tforgeworks/Perry-s-repo/wheel-cap/wheel_cap_CAP5372.stl

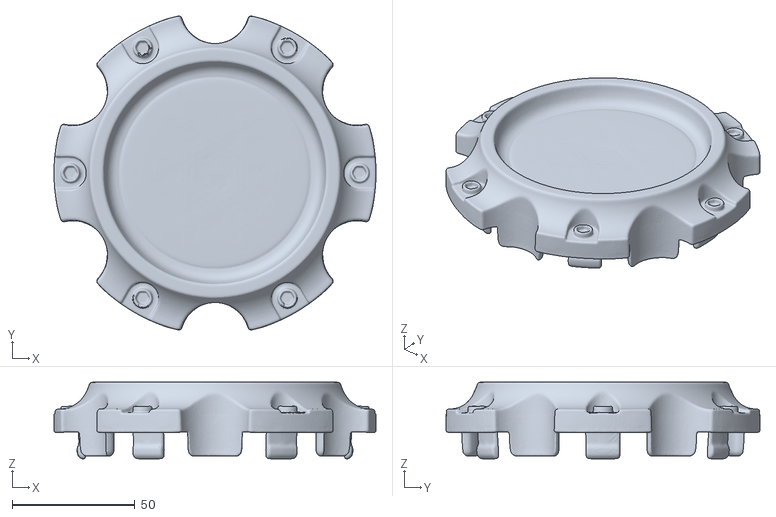
[picture p9: CAD file, 2026-09-30]
wheel-cap/wheel_cap_CAP5372.stl
131.1 x 127.8 x 31.2
