tforgeworks/Perry-s-repo/knob/knob_pointer.stl

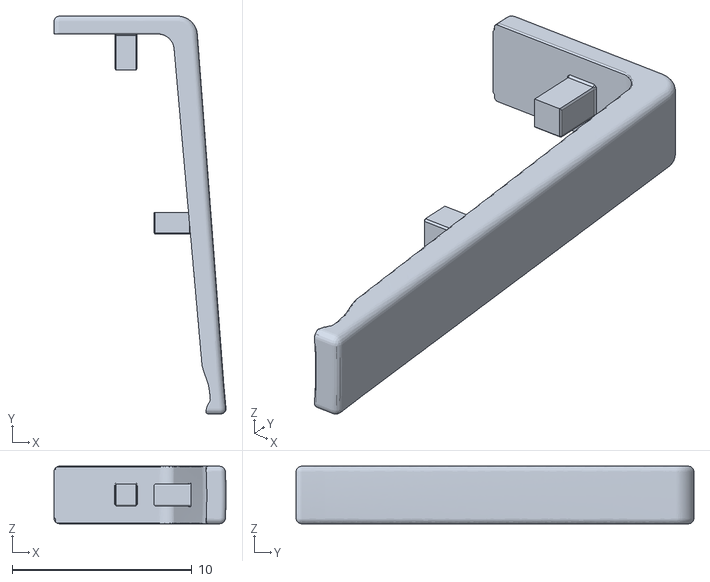
[picture p10: CAD file, 2026-10-23]
knob/knob_pointer.stl
9.56 x 22.1 x 3.20
