tforgeworks/Perry-s-repo/knob/knob_2color.3mf

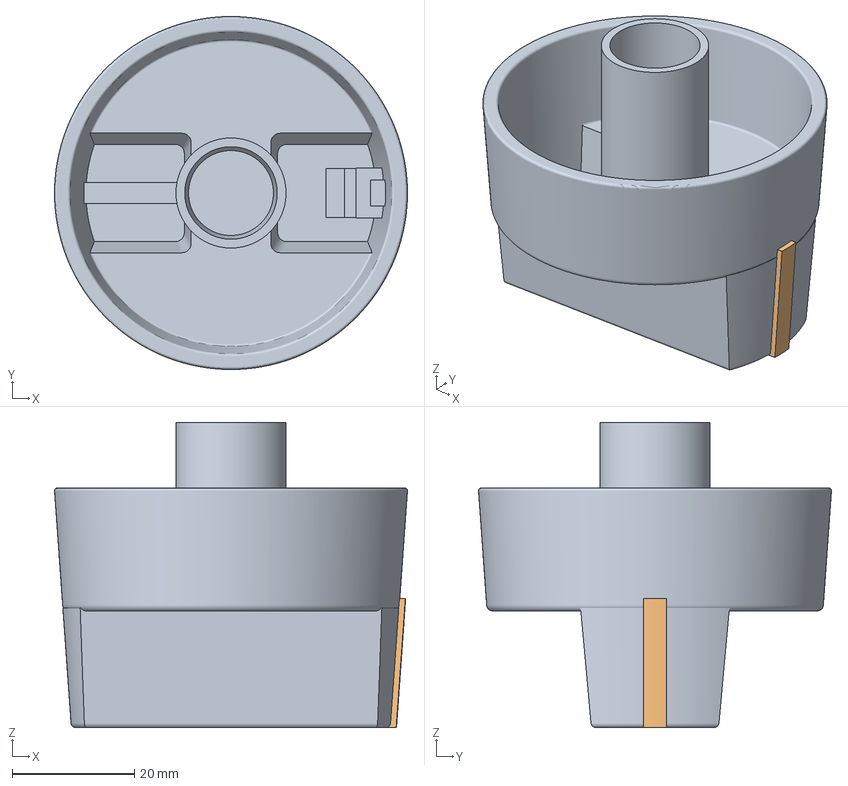
[picture p11: CAD file, 2026-10-23]
knob/knob_2color.3mf
57.7 x 57.7 x 50.0 mm
knob_body
pointer
