tforgeworks/Perry-s-repo/(list of files, cad)

Other CAD files:
knob/knob.stl
knob/knob_body.stl
