tforgeworks/Perry-s-repo/(commit log)

2026-09-30 Add wheel cap build pipeline and GitHub Actions workflow
    Scripts to download the CAP5372-61397 scan, align it, average it over the
    12 D6 symmetry transforms, mesh it into a watertight STL, and verify it
    against the scan. The workflow runs the whole build on GitHub Actions and
    commits the STL and verification report back to main.
    Claude-Session: https://claude.ai/code/session_01Bi3wXgZ23e6YQBbdjndkDn
2026-09-30 Build wheel cap STL and verification report [skip ci]
    [wheel_cap_CAP5372.stl]
2026-09-30 Robust symmetry fit and axis tilt refinement
    Scan defects (a missing patch at one clip, a warped inner lip) pulled the
    least-squares symmetry fit. The fit now uses a pseudo-Huber cost, and a
    small axis tilt is removed by fitting a plane to the height maps minus
    their D6 average. On the synthetic test cap the mean deviation from the
    true shape drops from 0.014 to 0.009 mm.
    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
2026-10-23 Add printable chrome bar knob rebuilt from its 3D scan
    The model is built from dimensions measured on the scan: a drafted skirt
    (4.1 deg) with a 2.6 mm wall, a hollow grip bar with two pockets, the shaft
    sleeve and bore, the pointer block and rib, and the red pointer as a separate
    part for two-color printing. The broken half of the sleeve is restored.
    It matches the scan to 0.06 mm median.
    Claude-Session: https://claude.ai/code/session_01Wzw9pK2jGBxd8BmX9eu53u
2026-10-23 Rebuild knob with fillets, raised pointer and scan-matched inner details
    The knob is now a signed distance model with rounded booleans, so every
    edge carries its own fillet or round, meshed at 0.08 mm. Surfaces that
    were simplified before now follow the scan: the skirt's measured wall
    profile, bar and pocket ends whose curvature changes with height, the
    pointer block heights, the insert wedge, pad and holes, the rib with its
    sloped end boss and the shelves in the left pocket. The pointer is a
    raised strip printed separately with locating pins, like the original
    insert. The model matches the scan to 0.03 mm median, and
    overlay_check.py lists any remaining disagreement.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
2026-10-23 Smooth the knob's seams and refine the pointer block and rib features
    The bar end now blends into the skirt as one surface, and the pocket ends
    blend into the cup wall below the floor, removing the seam lines at both
    joins. The skirt profiles follow a smooth spline through the measured
    points instead of straight segments. Following the photos of the
    original: the hole in the tip block and the left pocket shelves are
    removed, the pad on the tall block is narrowed to 0.45 mm, the rib's end
    boss is centred on the rib and just touches the pocket end wall, and the
    rib top gets its trapezoidal dip next to the boss.
    Claude-Session: https://cl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
2026-10-23 Shape the rib dip as a plan trapezoid and close the recess-to-tip gap
    The dip in the rib's top now narrows in plan from 2.0 mm at the boss end
    to 1.3 mm at its steep far end, as on the scan. The recess in the tall
    block's top runs up to the tip's face, which moves to x=22.7 to match.
    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
2026-10-23 Keep the sleeve's fillet off the bar's front face
    The sleeve's solid ended 1.75 mm behind the front face, inside the reach
    of its 2 mm fillet to the pocket bottoms, which pushed the front face out
    by 0.014 mm in a ring around the sleeve. It now ends 2.25 mm behind the
    face, and the face is flat.
    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
